halfdanrump/raspi_3g_shield/BOM.docx

COMPONENT | SUPPLIER LINK
Switch Sw1 | http://www.digikey.com/product-search/en?keywords=SW1103CT-ND
SMF05C | http://www.digikey.com/product-detail/en/semtech-corporation/SMF05C.TCT/SMF05CCT-ND/1000977
SIM Card Connector | http://www.digikey.com/product-search/en?keywords=101-00306-82-1-ND
GSM and GPS Antenna Connector (Qty x 2) | http://www.digikey.com/product-search/en?keywords=490-11804-6-ND
LDO | http://www.digikey.com/product-search/en?keywords=576-4072-ND
Inductor (L2) | http://www.digikey.com/product-search/en?keywords=445-6167-1-ND
Inductor (L1) | Do Not Populate (GPS_External Antenna)
P1 (Header) | Header, 10-Pin (Do not populate)
P2 (Header) Female (RPi B header) | https://www.adafruit.com/products/1658
LED 1 and 2 (Green, Blue) (Qty x 2) | http://www.digikey.com/product-search/en?keywords=597-3311-402F
33pf ceramic cap (C1,C2,C6) | http://www.digikey.com/product-detail/en/wurth-electronics-inc/885012007013/732-7817-1-ND/5454444
100uf Electrolytic Caps (C4,C5,C8 Qty x3) | http://www.digikey.com/product-detail/en/wurth-electronics-inc/865090445008/732-8370-1-ND/5728327
10Pf Cap (C7) | http://www.digikey.com/product-detail/en/wurth-electronics-inc/885012007010/732-7814-1-ND/5454441
1uF Cap (C9) | http://www.digikey.com/product-detail/en/panasonic-electronic-components/EEE-FC1V1R0R/PCE4024CT-ND/817486
330uF Electrolytic Cap (C10) | http://www.digikey.com/product-detail/en/panasonic-electronic-components/EEE-1VA331P/PCE3959TR-ND/766124
100nf Cap (C11) | http://www.digikey.com/product-detail/en/knowles-syfer/0805Y0500104KXTM01/1608-1017-1-ND/5730216
10uF Cap (C3) | http://www.digikey.com/product-detail/en/murata-electronics-north-america/GRM21BC81D106KE51L/490-10500-2-ND/5027585
R1 100 Ohms | http://www.digikey.com/product-detail/en/panasonic-electronic-components/ERJ-T06J101V/ERJ-T06J101V-ND/2340193
5 Ohms (R2, R3) | http://www.digikey.com/product-detail/en/vishay-dale/CRCW08054R99FKEAHP/541-4.99TCT-ND/5326922

BILL OF MATERIALS
