halfdanrump/raspi_3g_shield/Project Outputs for SIM5320  RPi Breakout Board/SIM5320_RPi_BB.PDF

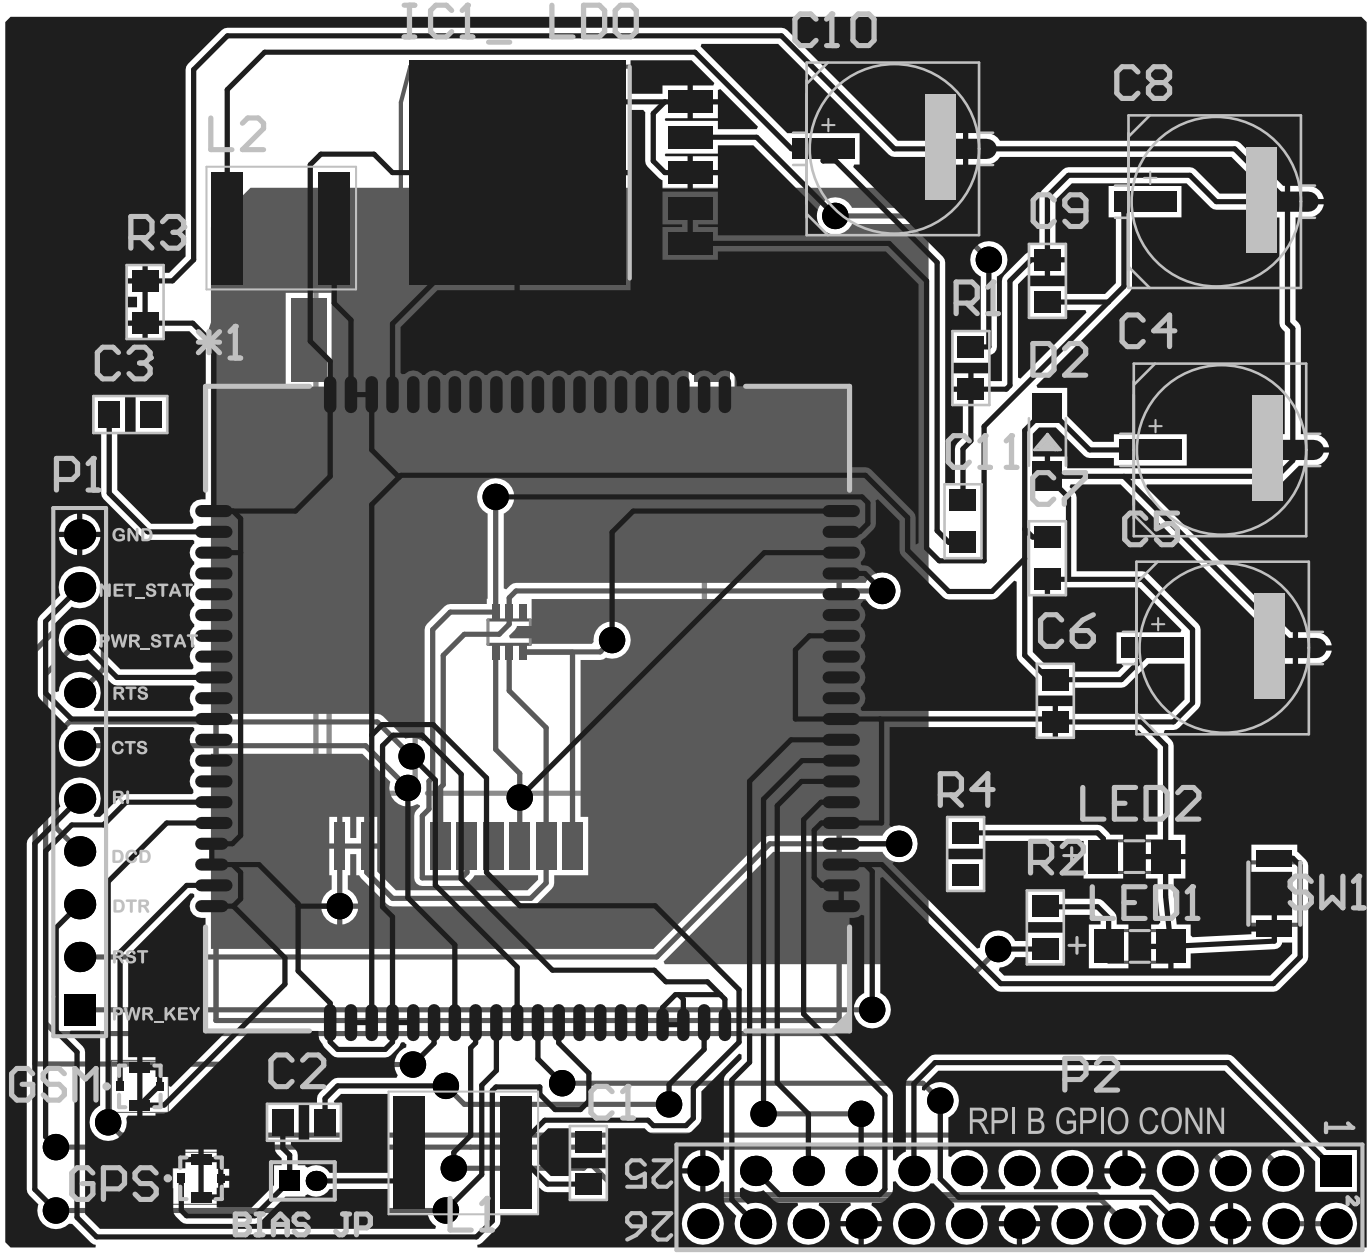
[picture p1: page 1]

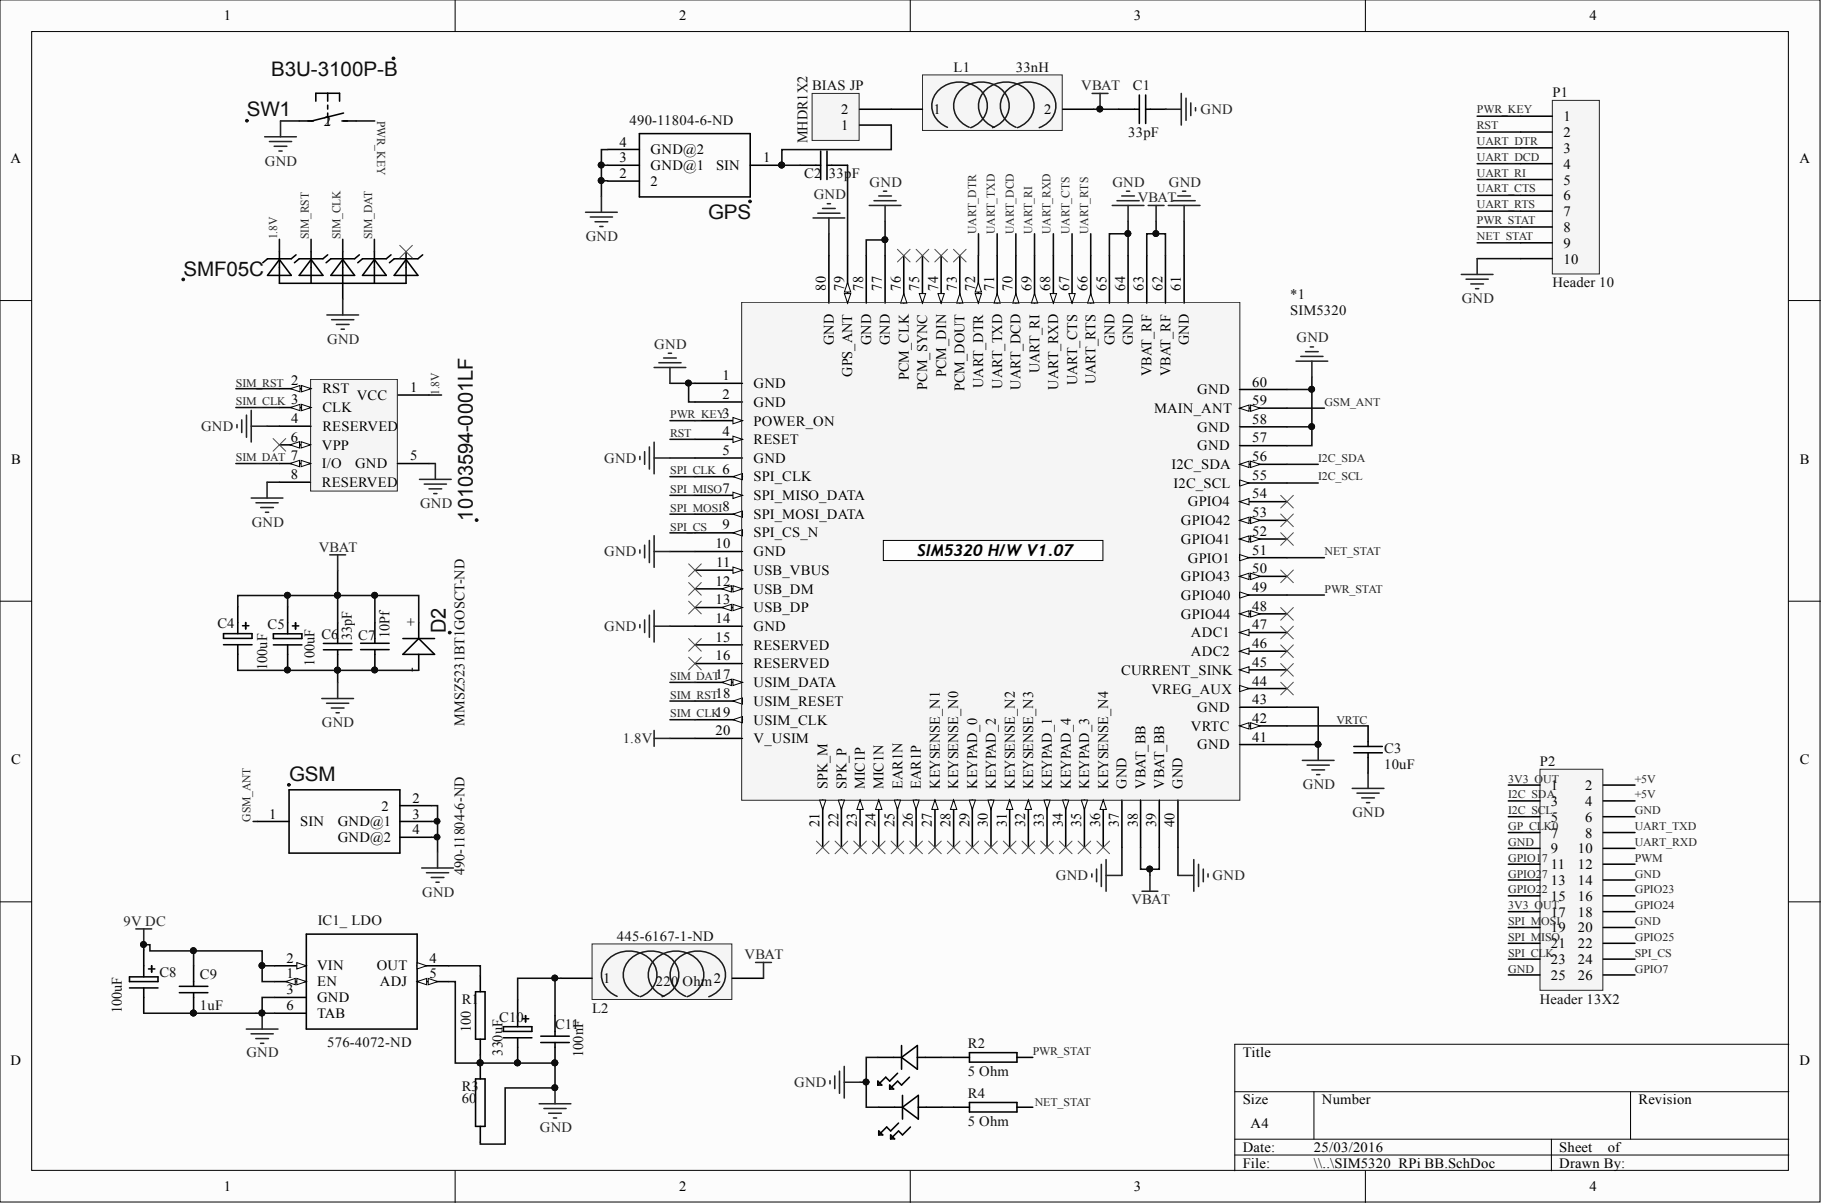
[picture p2: page 2]

4 2
4 1

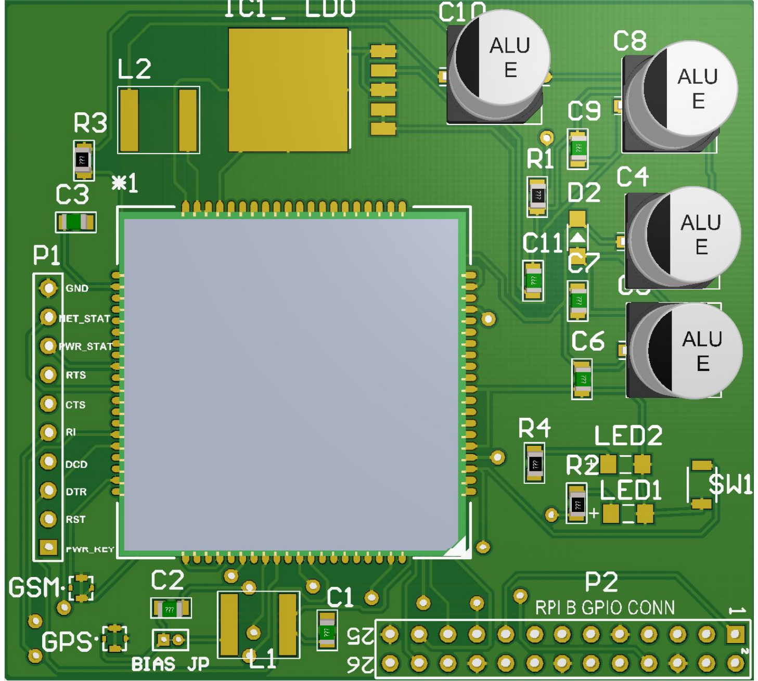
[picture p3: page 3]
