halfdanrump/raspi_3g_shield/(list of files, drawings)

Other design files:
Project Parts Library/597-3311-402F.PcbLib
Project Parts Library/597-3311-402F.SchLib
Project Parts Library/2220.PcbLib
Project Parts Library/2220.SchLib
Project Parts Library/5320BB_Int_Lib/Project Outputs for 5320BB_Int_Lib/5320BB_Int_Lib/10103594-0001LF.PcbLib
Project Parts Library/5320BB_Int_Lib/Project Outputs for 5320BB_Int_Lib/5320BB_Int_Lib/10103594-0001LF.SchLib
Project Parts Library/5320BB_Int_Lib/Project Outputs for 5320BB_Int_Lib/5320BB_Int_Lib/B3U-1000.PcbLib
Project Parts Library/5320BB_Int_Lib/Project Outputs for 5320BB_Int_Lib/5320BB_Int_Lib/B3U-1000.SchLib
Project Parts Library/5320BB_Int_Lib/Project Outputs for 5320BB_Int_Lib/5320BB_Int_Lib/MIC29302WU.PcbLib
Project Parts Library/5320BB_Int_Lib/Project Outputs for 5320BB_Int_Lib/5320BB_Int_Lib/MIC29302WU.SchLib
Project Parts Library/5320BB_Int_Lib/Project Outputs for 5320BB_Int_Lib/5320BB_Int_Lib/MM8030-2610RJ3.PcbLib
Project Parts Library/5320BB_Int_Lib/Project Outputs for 5320BB_Int_Lib/5320BB_Int_Lib/MM8030-2610RJ3.SchLib
Project Parts Library/5320BB_Int_Lib/Project Outputs for 5320BB_Int_Lib/5320BB_Int_Lib/SIM5320 pcb.PcbLib
Project Parts Library/5320BB_Int_Lib/Project Outputs for 5320BB_Int_Lib/5320BB_Int_Lib/SIM5320 sch.SchLib
Project Parts Library/5320BB_Int_Lib/Project Outputs for 5320BB_Int_Lib/5320BB_Int_Lib/SMD Capacitors 0805.PcbLib
Project Parts Library/5320BB_Int_Lib/Project Outputs for 5320BB_Int_Lib/5320BB_Int_Lib/SMD Capacitors 0805.SchLib
Project Parts Library/5320BB_Int_Lib/Project Outputs for 5320BB_Int_Lib/5320BB_Int_Lib/SMD Capacitors Electrolytic.PcbLib
Project Parts Library/5320BB_Int_Lib/Project Outputs for 5320BB_Int_Lib/5320BB_Int_Lib/SMD Capacitors Electrolytic.SchLib
Project Parts Library/5320BB_Int_Lib/Project Outputs for 5320BB_Int_Lib/5320BB_Int_Lib/SMD Capacitors Other.PcbLib
Project Parts Library/5320BB_Int_Lib/Project Outputs for 5320BB_Int_Lib/5320BB_Int_Lib/SMD Capacitors Other.SchLib
Project Parts Library/5320BB_Int_Lib/Project Outputs for 5320BB_Int_Lib/5320BB_Int_Lib/SMD Connectors.PcbLib
Project Parts Library/5320BB_Int_Lib/Project Outputs for 5320BB_Int_Lib/5320BB_Int_Lib/SMD Connectors.SchLib
Project Parts Library/5320BB_Int_Lib/Project Outputs for 5320BB_Int_Lib/5320BB_Int_Lib/SMD Diodes.PcbLib
Project Parts Library/5320BB_Int_Lib/Project Outputs for 5320BB_Int_Lib/5320BB_Int_Lib/SMD Diodes.SchLib
Project Parts Library/5320BB_Int_Lib/Project Outputs for 5320BB_Int_Lib/5320BB_Int_Lib/SMD Resistors 0805.PcbLib
Project Parts Library/5320BB_Int_Lib/Project Outputs for 5320BB_Int_Lib/5320BB_Int_Lib/SMD Resistors 0805.SchLib
Project Parts Library/5320BB_Int_Lib/Project Outputs for 5320BB_Int_Lib/5320BB_Int_Lib/SMD Resistors.PcbLib
Project Parts Library/5320BB_Int_Lib/Project Outputs for 5320BB_Int_Lib/5320BB_Int_Lib/SMD Resistors.SchLib
Project Parts Library/5320BB_Int_Lib/Project Outputs for 5320BB_Int_Lib/5320BB_Int_Lib/SMD-DIODE-ZENER-15V-500MW_SOD-123_.PcbLib
Project Parts Library/5320BB_Int_Lib/Project Outputs for 5320BB_Int_Lib/5320BB_Int_Lib/SMD-DIODE-ZENER-15V-500MW_SOD-123_.SchLib
Project Parts Library/5320BB_Int_Lib/Project Outputs for 5320BB_Int_Lib/5320BB_Int_Lib/SMF05C.PcbLib
Project Parts Library/5320BB_Int_Lib/Project Outputs for 5320BB_Int_Lib/5320BB_Int_Lib/SMF05C.SchLib
Project Parts Library/10103594-0001LF.PcbLib
Project Parts Library/10103594-0001LF.SchLib
Project Parts Library/912283001.PcbLib
Project Parts Library/912283001.SchLib
Project Parts Library/B3U-1000.PcbLib
Project Parts Library/B3U-1000.SchLib
Project Parts Library/MIC29302WU.PcbLib
Project Parts Library/MIC29302WU.SchLib
Project Parts Library/MM8030-2610RJ3.PcbLib
Project Parts Library/MM8030-2610RJ3.SchLib
Project Parts Library/SIM5320 pcb.PcbLib
Project Parts Library/SIM5320 sch.SchLib
Project Parts Library/SMD Capacitors 0805.PcbLib
Project Parts Library/SMD Capacitors 0805.SchLib
Project Parts Library/SMD Capacitors Electrolytic.PcbLib
Project Parts Library/SMD Capacitors Electrolytic.SchLib
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
