halfdanrump/raspi_3g_shield/(threads)

Thread 1 (2018-02-13):

Notes and suggestions

CRImier, 2018-02-13:
Hi! I've found your breakout on the Internet, and I've noticed some issues with it:

- The power traces are really thin. SIM5320 can draw large currents, and those traces can cause a voltage drop, causing the modem to reset once it's under load.
- I also suggest decreasing the length of VBAT traces, again, so that current flows better and there are no voltage drops
- You don't actually have to have the power button, it's usually more trouble than it's worth - especially in Raspberry Pi shield. Just short the PWR_KEY to GND, it will cause the module to always auto-start.
- You don't have 10pF and 33pF capacitors on audio lines that are used for decreasing impact of GSM noise on analog audio. I suggest adding them, as per datasheet.
- I also suggest breaking out USB - it's a really useful way to connect to your SIM5320, as it provides not one, but multiple hardware UARTs.
- RPi and SIM5320 I2C lines are connected together - you don't actually have to do that, AFAIK SIM5320 I2C is only used for external audio chipset control, and it's supposed to be master, so it doesn't make any practical sense
- Same for SPI - AFAIK it's used when SIM5320 is the only CPU (say, a phone based solely on SIM5320), for driving a display.
- Both pins of R3 are shorted by GND. As a result, ADJ is grounded and the LDO won't set proper voltage because the feedback voltage divider is effectively not present.
- There are traces connecting GND pads, even though there's a ground fill. A ground fill is a much more effective way of connecting grounds together - and some of these GND traces actually prevent the ground fill from going where it should go, it seems.
- Electrolytic capacitors on the 3D render are reversed. It's OK, but don't refer to the 3D render during assembly =)
- Top and bottom ground planes are only connected because of plated holes on the headers - you should add some vias, maybe even do via stitching
